HobbyFactory/PCB-GS66516B-IMS-HB/README.md

# PCB-GS66516B-IMS-HB
GaN (GS66516B) Half-Bridge designed on a metal substrate printed circuit board, including the gate drivers.

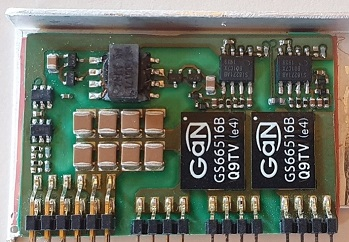
[picture p1: doc/photo.jpg]
photo_of_proto


All data included, designed in free tool KiCad. For more details check article:
Efficiency optimization of totem pole PFC with Gallium Nitride semiconductors (doi:10.15199/48.2021.06.07)
