HobbyFactory/PCB-GS66516B-IMS-HB/Board.PNG

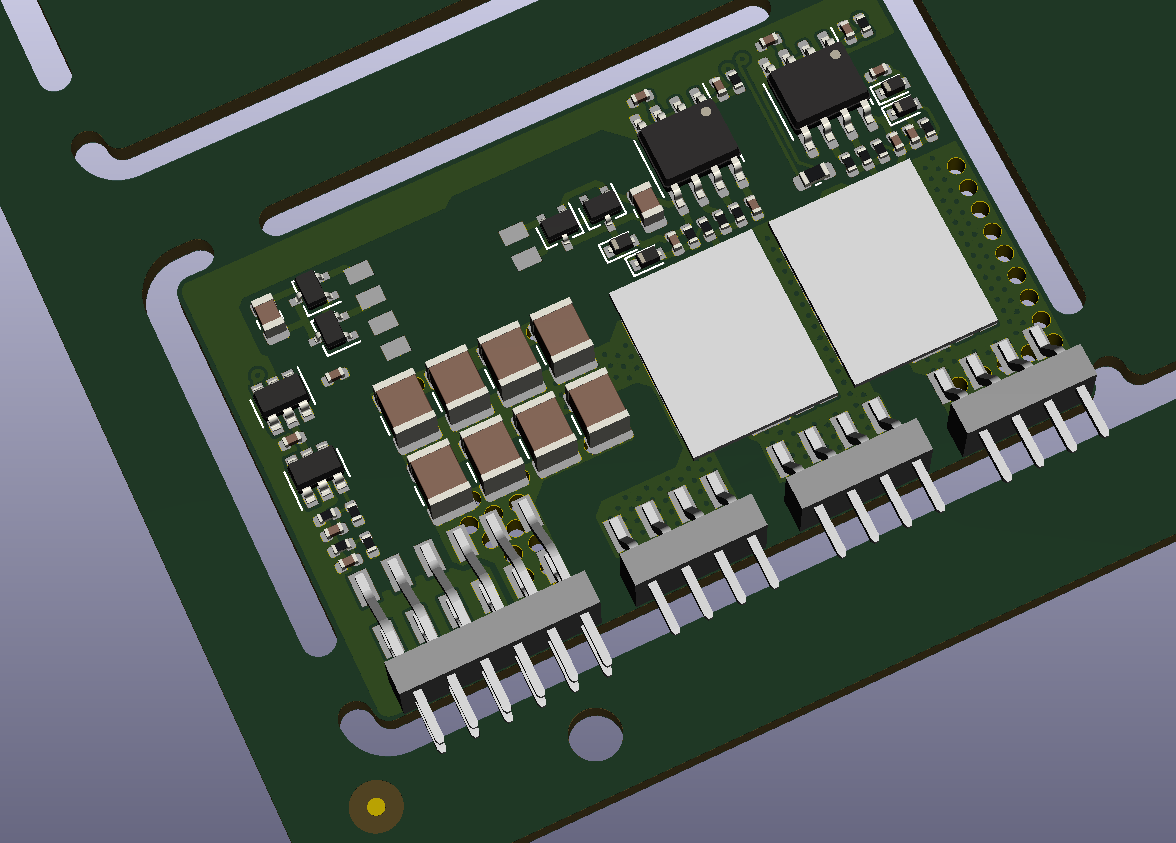
Board.PNG
