HobbyFactory/PCB-GS66516B-IMS-HB/doc/BOM.xlsx

Sheet: V2
Item | Qty | Reference(s) | Value
1 | 8 | C1, C2, C3, C4, C5, C6, C7, C8 | 150nF/630V
2 | 4 | C9, C10, C13, C17 | N/A
3 | 5 | C11, C12, C14, C16, C22 | 100nF
4 | 4 | C15, C20, C21, C23 | 1uF
5 | 2 | C18, C19 | 4.7uF
6 | 4 | D1, D2, D3, D4 | BAV99W
7 | 2 | D5, D6 | 5.6V
8 | 2 | D7, D8 | 12V
~~9~~ | ~~3~~ | ~~FID1, FID2, FID3~~ | ~~Fiducial~~
~~10~~ | ~~5~~ | ~~H1, H2, H3, H4, H5~~ | ~~Panel mounting hole~~
11 | 1 | J1 | PinHeader_SMD_2x6
12 | 3 | J2, J3, J4 | PinHeader_SMD_1x4
13 | 2 | Q1, Q2 | GS66516B-E01-MR
14 | 6 | R1, R4, R7, R8, R9, R10 | 10R
15 | 2 | R2, R5 | 2R2
16 | 4 | R3, R6, R11, R12 | 4k7
17 | 2 | R13, R14 | 1k
18 | 1 | T1 | WCT.00171
19 | 1 | TH1 | Thermistor_NTC
20 | 2 | U1, U2 | SN74LVC1G98DBVR
21 | 2 | U3, U4 | Si8271AB-IS

Sheet: V1
Item | Qty | Reference(s) | Value
1 | 8 | C1, C2, C3, C4, C5, C6, C7, C8 | 150nF
2 | 4 | C9, C10, C13, C17 | N/A
3 | 5 | C11, C12, C14, C16, C22 | 100nF
4 | 4 | C15, C20, C21, C23 | 1uF
5 | 2 | C18, C19 | 4.7uF
6 | 4 | D1, D2, D3, D4 | BAV99W
7 | 2 | D5, D6 | 5.6V
8 | 2 | D7, D8 | 12V
~~9~~ | ~~3~~ | ~~FID1, FID2, FID3~~ | ~~Fiducial~~
~~10~~ | ~~5~~ | ~~H1, H2, H3, H4, H5~~ | ~~Panel mounting hole~~
11 | 1 | J1 | PinHeader_SMD_2x6
12 | 3 | J2, J3, J4 | PinHeader_SMD_1x4
13 | 2 | Q1, Q2 | GS66516B-E01-MR
14 | 7 | R1, R4, R5, R7, R8, R9, R10 | 10R
15 | 1 | R2 | 2R
16 | 4 | R3, R6, R11, R12 | 4k7
17 | 2 | R13, R14 | 1k
18 | 1 | T1 | WCT.00171
19 | 1 | TH1 | Thermistor_NTC
20 | 2 | U1, U2 | SN74LVC1G98DBVR
21 | 2 | U3, U4 | Si8271AB-IS
