HobbyFactory/PCB-GS66516B-IMS-HB/pdf/GS66516B_IMS_AssemblyDrawing.pdf

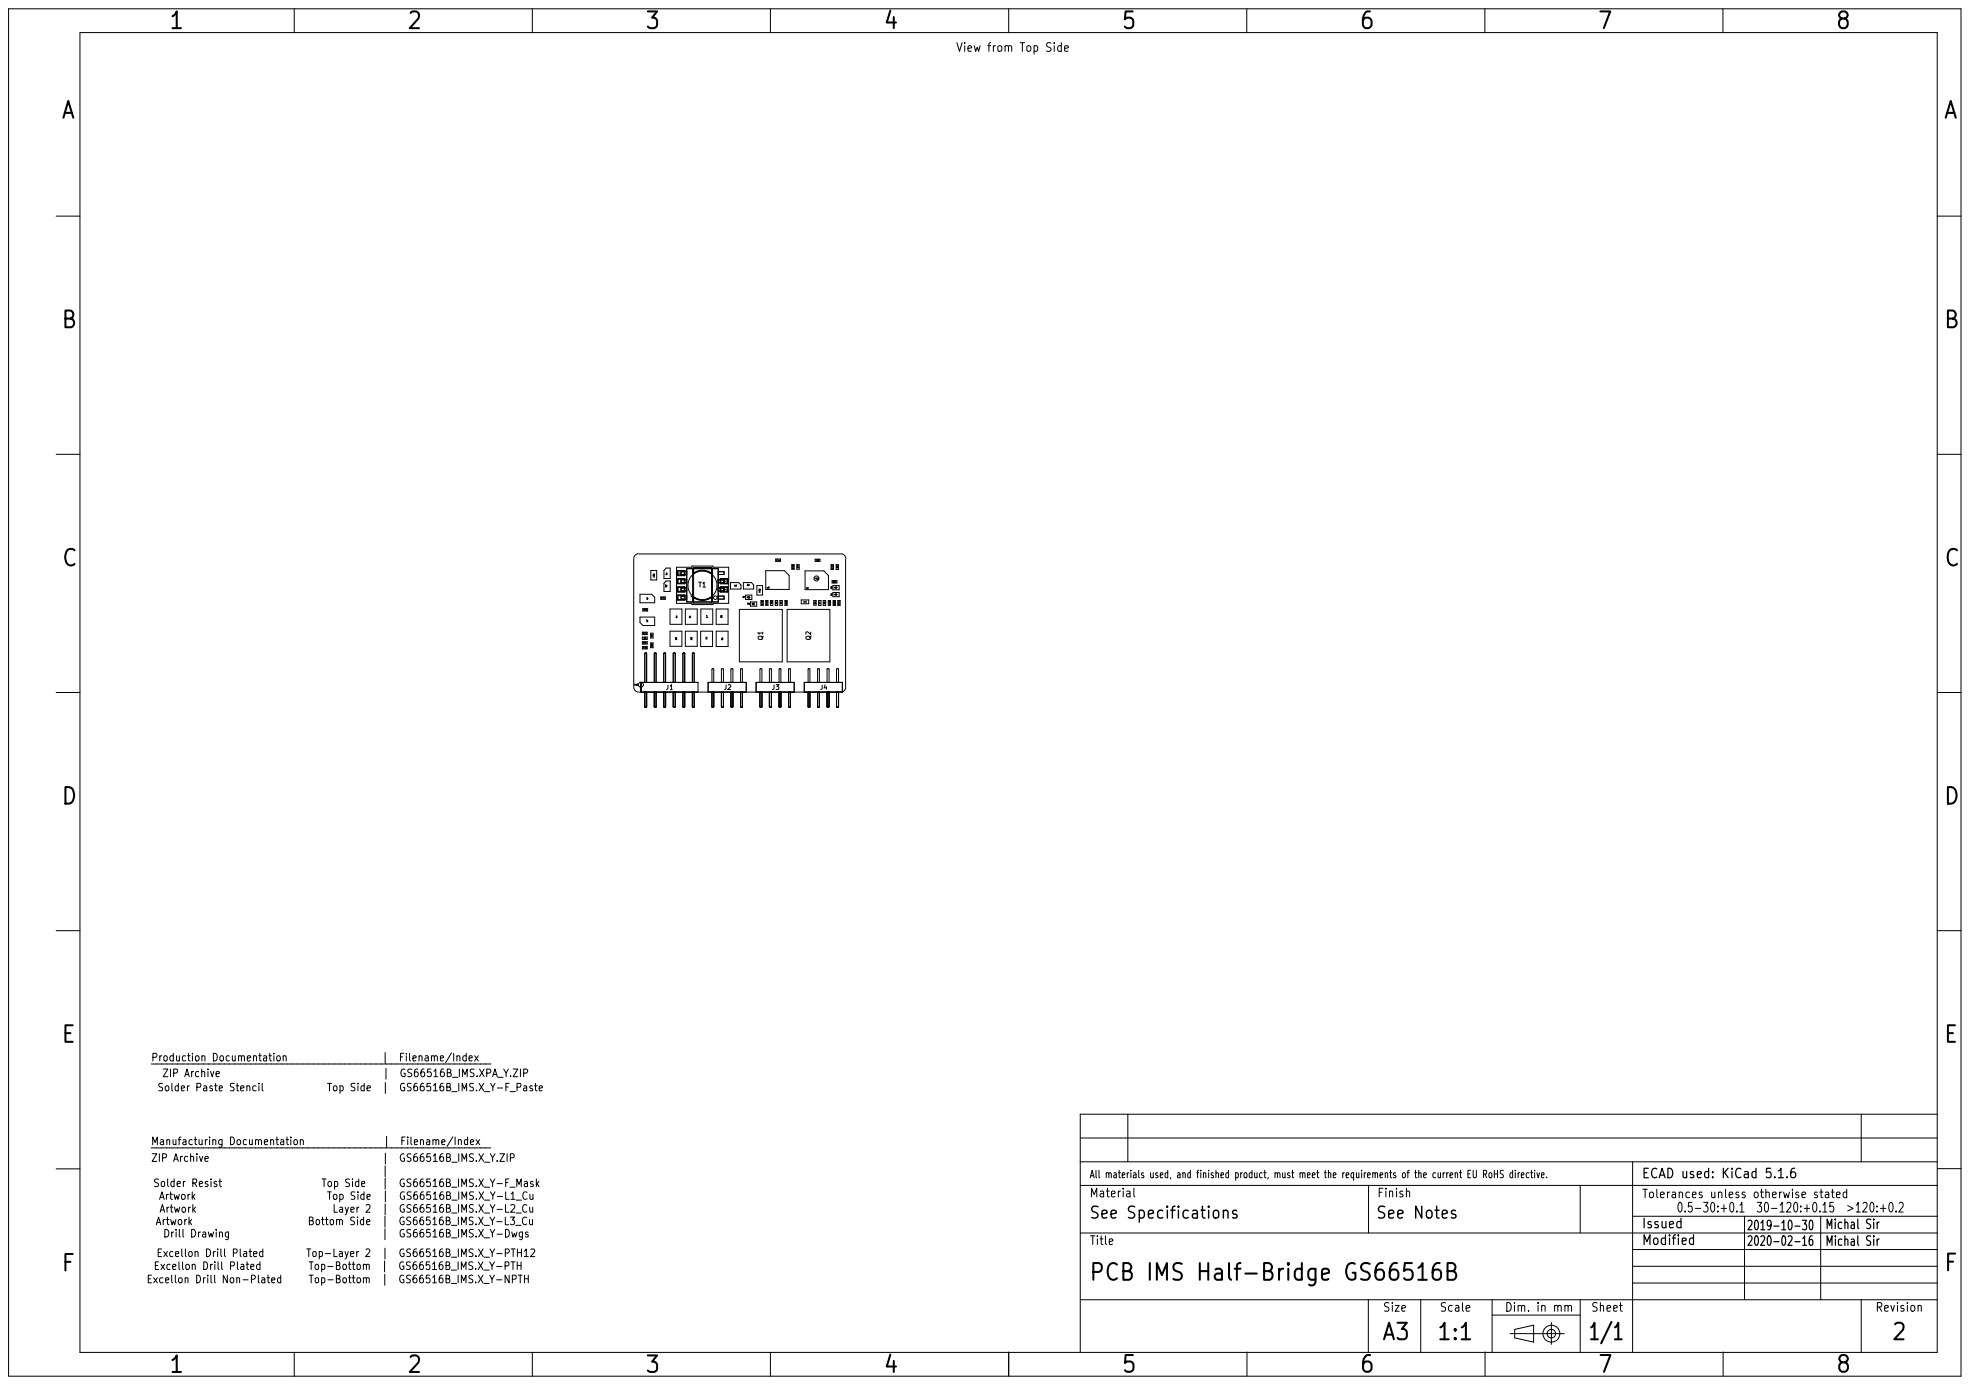
[picture p3: page 1]
