HobbyFactory/PCB-GS66516B-IMS-HB/pdf/GS66516B_IMS_Schematic.pdf

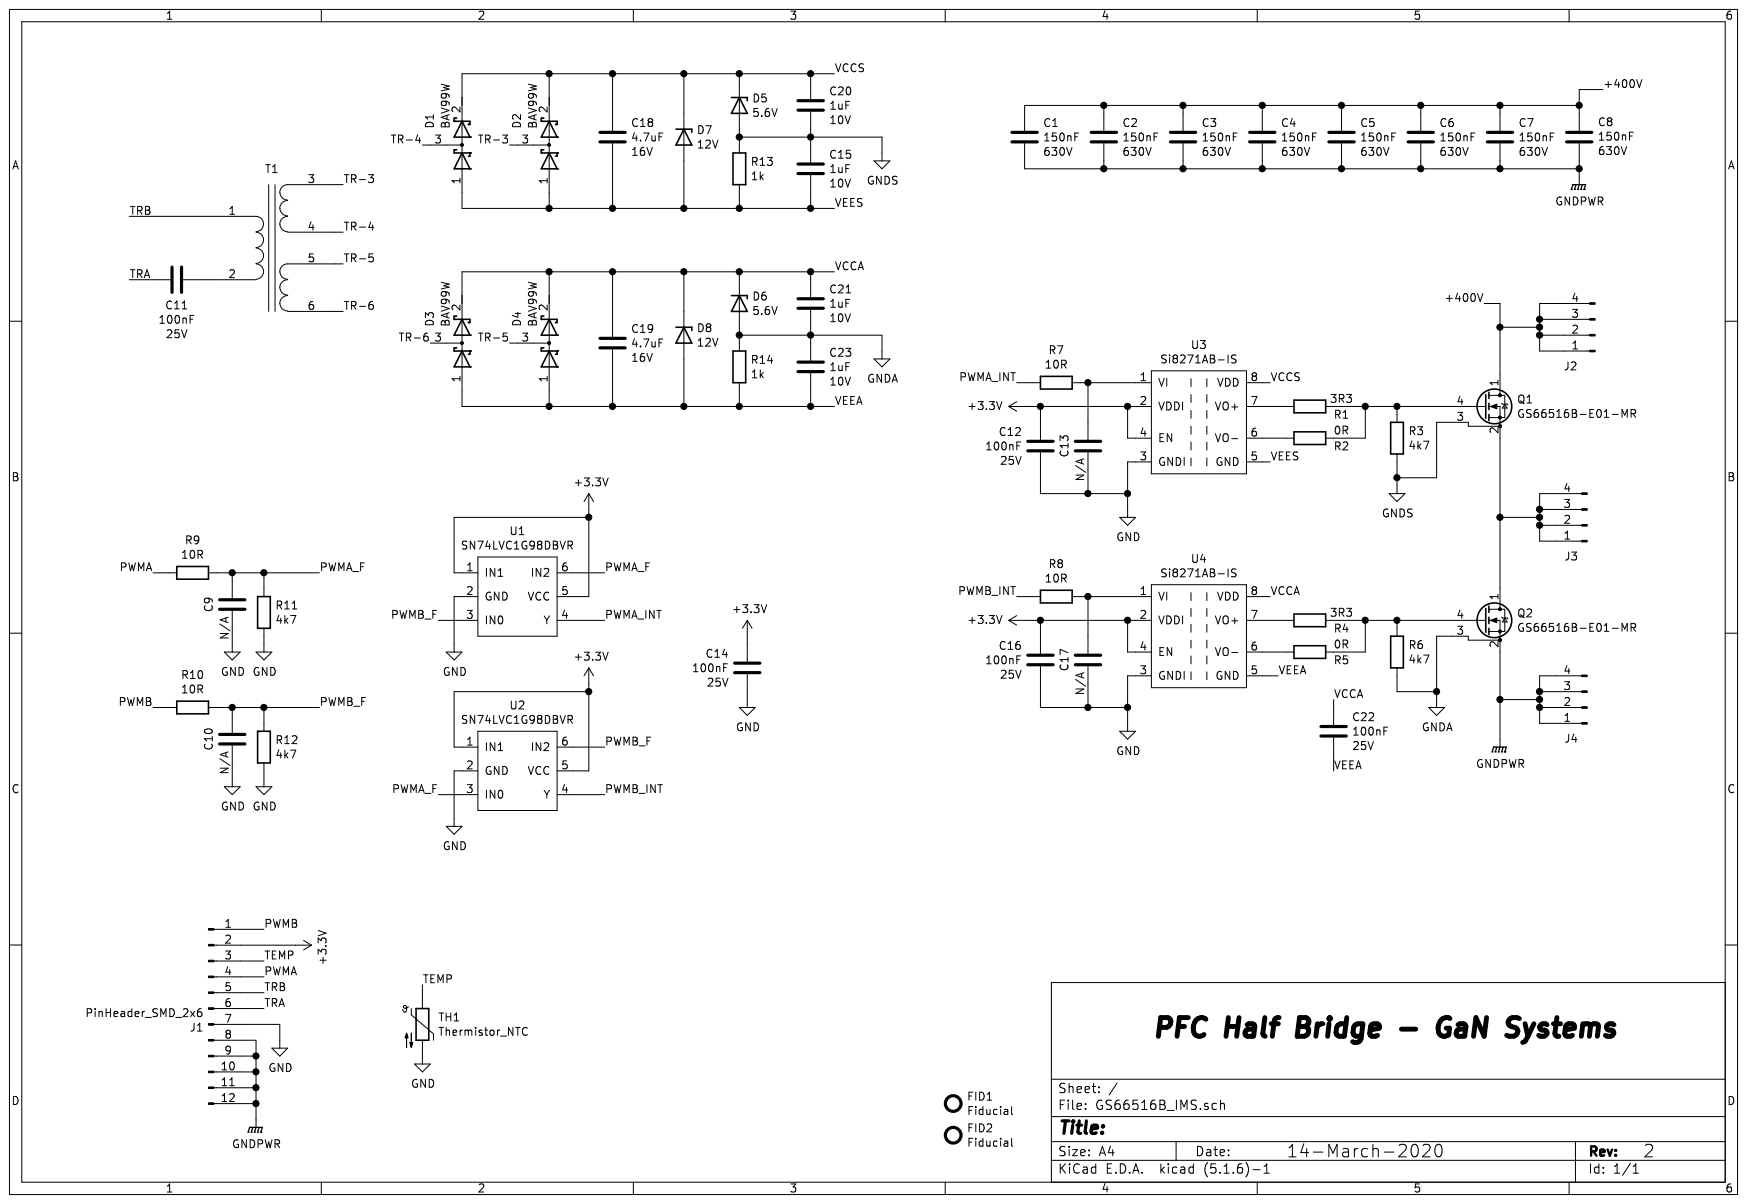
[picture p4: page 1]
