HobbyFactory/PCB-GS66516B-IMS-HB/pdf/GS66516B_IMS_PCBSpecification.pdf

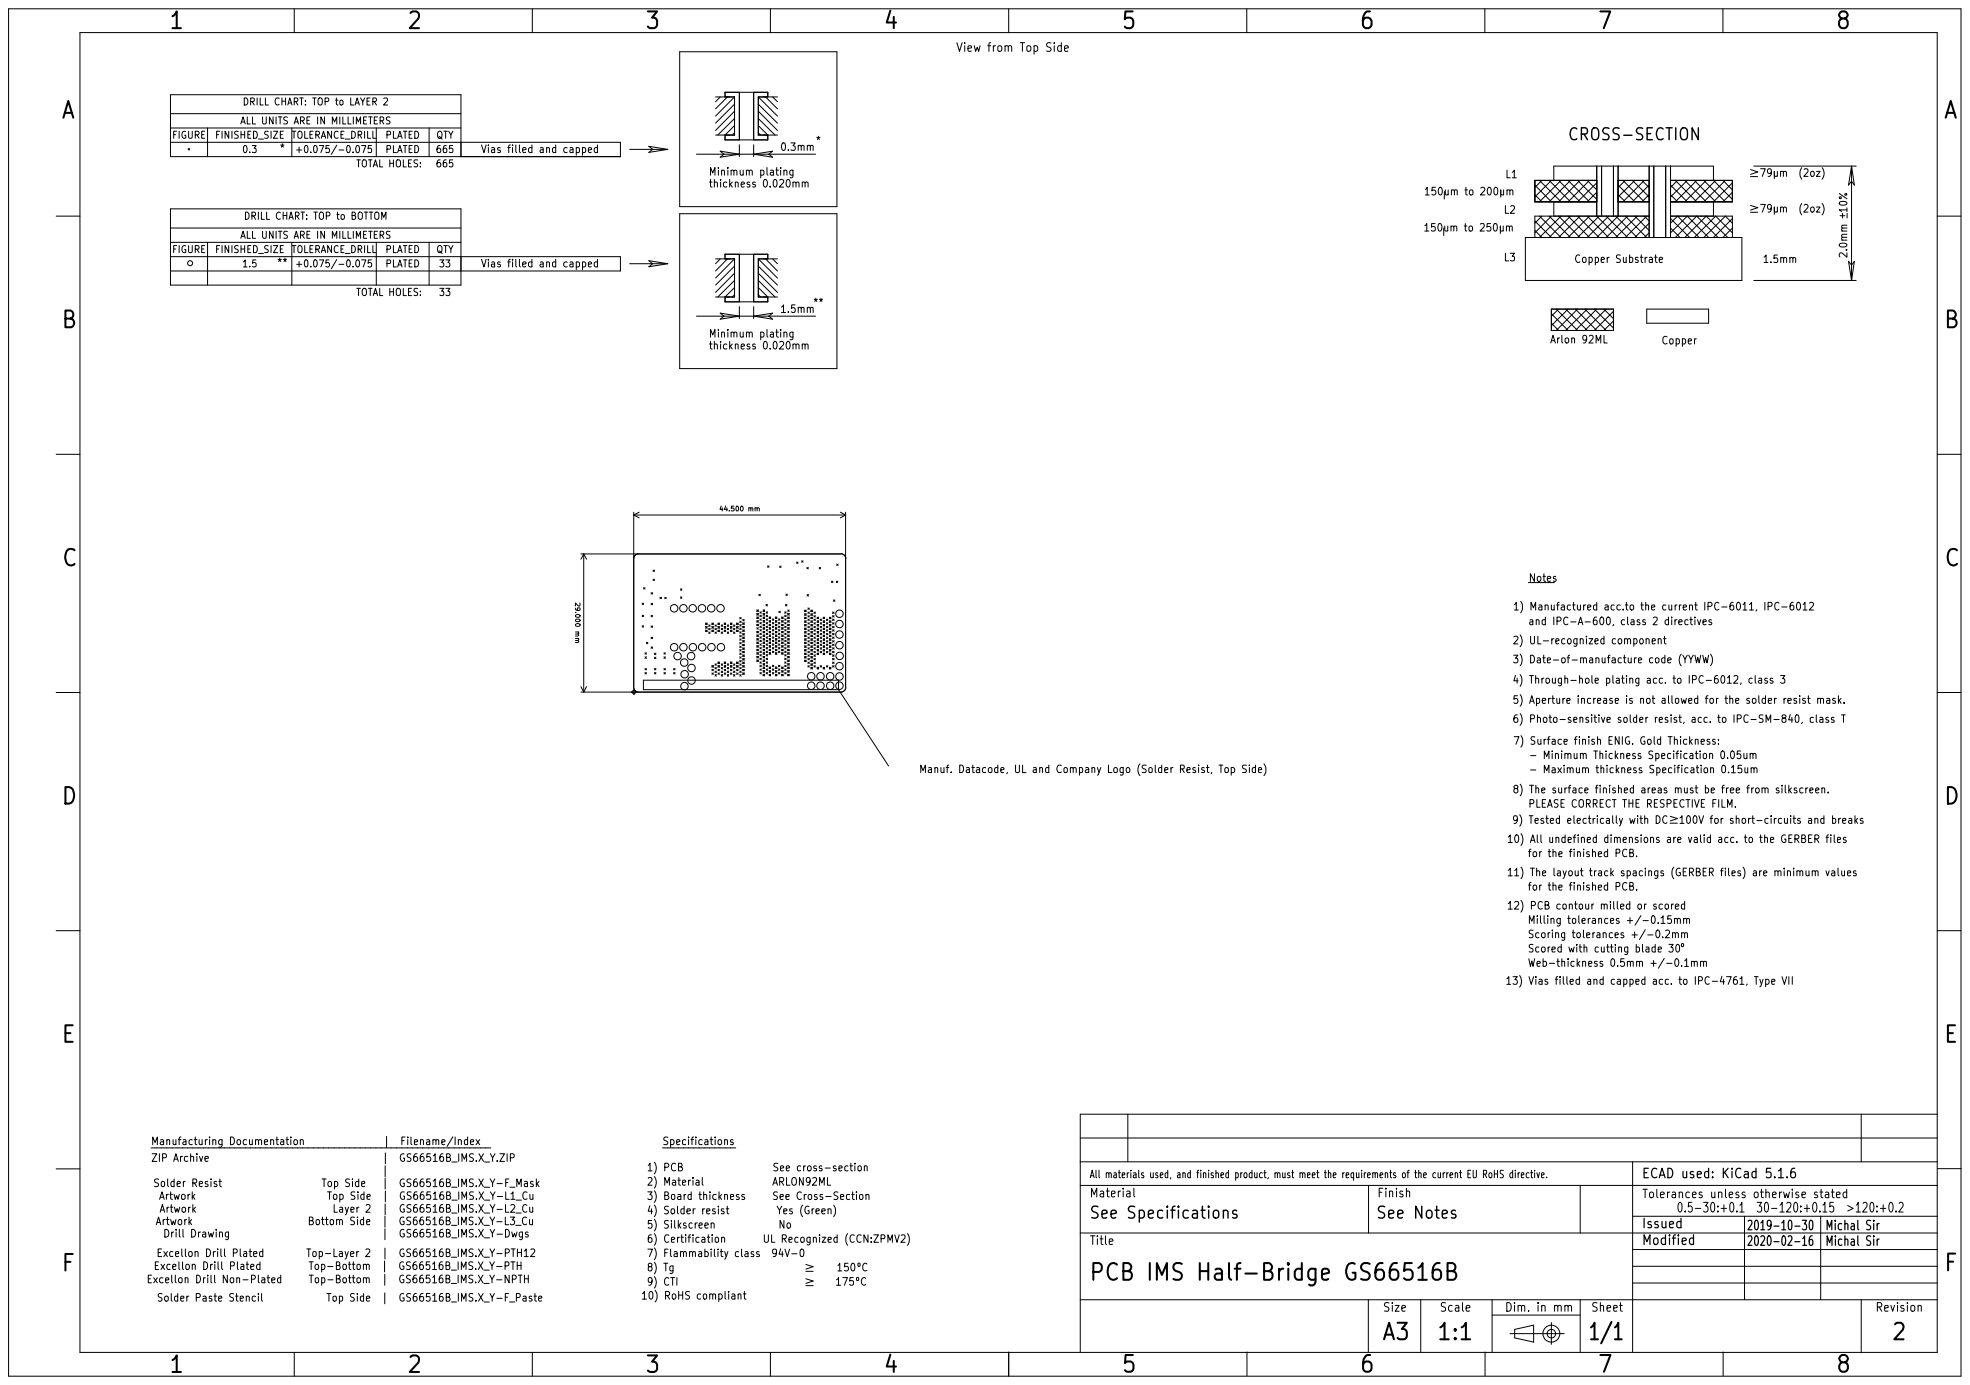
[picture p5: page 1]
