HobbyFactory/PCB-GS66516B-IMS-HB/GS66516B_IMS.kicad_pcb

## KiCad design GS66516B_IMS.kicad_pcb (2021-04-05)

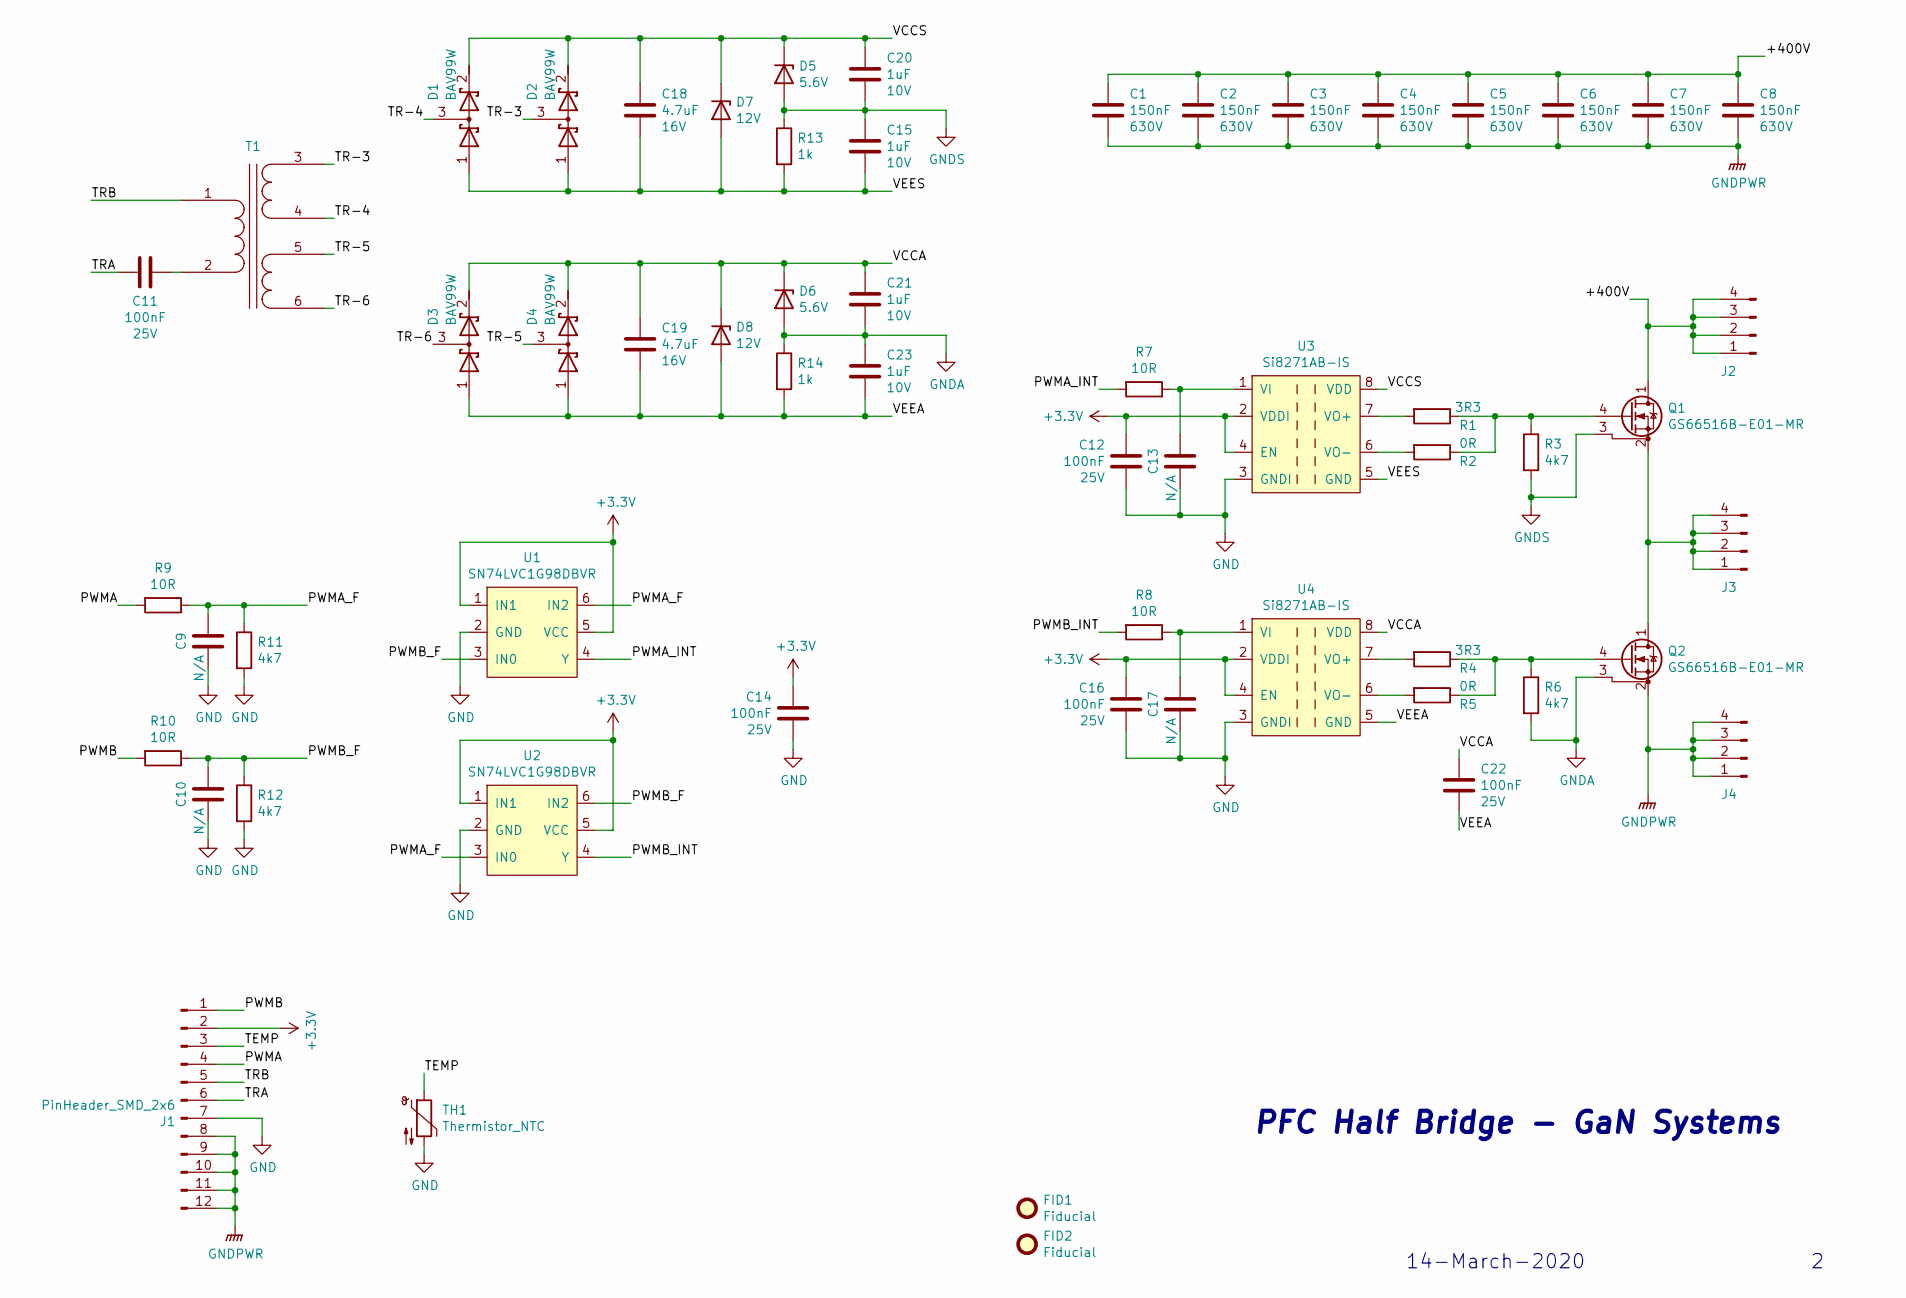
[picture p6: schematic GS66516B_IMS.sch]

Parts:
C1, C2, C3, C4, C5, C6, C7, C8: 150nF; C_1210_3225Metric; Voltage 630V
C9, C10, C13, C17: N/A; C_0402_1005Metric
C11, C12, C14, C16, C22: 100nF; C_0402_1005Metric; Voltage 25V
C15, C20, C21, C23: 1uF; C_0402_1005Metric; Voltage 10V
C18, C19: 4.7uF; C_0805_2012Metric; Voltage 16V
D1, D2, D3, D4: BAV99W; SOT-323_SC-70
D5, D6: 5.6V; D_SOD-523; Voltage 5.6V
D7: 12V; D_SOD-523; Voltage 12V
D8: 12V; D_SOD-523
FID1, FID2: Fiducial; Fiducial_0.5mm_Mask1mm
J1: PinHeader_SMD_2x6; PinHeader_SMD_Horizontal_2.00mm_2x6
J2, J3, J4: PinHeader_SMD_1x4; PinHeader_SMD_Horizontal_2.00mm_1x4_Modified
Q1, Q2: GS66516B-E01-MR; Transistor_GaN_GS66516B
R1, R4: 3R3; R_0402_1005Metric
R2, R5: 0R; R_0402_1005Metric
R3, R6, R11, R12: 4k7; R_0402_1005Metric
R7, R8, R9, R10: 10R; R_0402_1005Metric
R13, R14: 1k; R_0402_1005Metric
T1: Transformer_BPS_WCT.00171
TH1: Thermistor_NTC; R_0603_1608Metric
U1, U2: SN74LVC1G98DBVR; SOT-23-6
U3, U4: Si8271AB-IS; SOIC-8_3.9x4.9mm_P1.27mm

Connections:
+3V3: C12.1, C14.1, C16.1, J1.2, U1.1 (IN1), U1.5 (VCC), U2.1 (IN1), U2.5 (VCC), U3.2 (VDDI), U3.4 (EN), U4.2 (VDDI), U4.4 (EN)
/+400V: C1.1, C2.1, C3.1, C4.1, C5.1, C6.1, C7.1, C8.2, J2.1, J2.2, J2.3, J2.4, Q1.1 (D)
/PWMA: J1.4, R9.2
/PWMA_F: C9.1, R9.1, R11.1, U1.6 (IN2), U2.3 (IN0)
/PWMA_INT: R7.2, U1.4 (Y)
/PWMB: J1.1, R10.2
/PWMB_F: C10.1, R10.1, R12.1, U1.3 (IN0), U2.6 (IN2)
/PWMB_INT: R8.2, U2.4 (Y)
/TEMP: J1.3, TH1.1
/TR-3: D2.3 (common), T1.3 (SA)
/TR-4: D1.3 (common), T1.4 (SB)
/TR-5: D4.3 (common), T1.5 (SC)
/TR-6: D3.3 (common), T1.6 (SD)
/TRA: C11.2, J1.6
/TRB: J1.5, T1.1 (AA)
/VCCA: C19.1, C21.1, C22.1, D3.2 (K), D4.2 (K), D6.1 (K), D8.1 (K), U4.8 (VDD)
/VCCS: C18.1, C20.1, D1.2 (K), D2.2 (K), D5.1 (K), D7.1 (K), U3.8 (VDD)
/VEEA: C19.2, C22.2, C23.2, D3.1 (A), D4.1 (A), D8.2 (A), R14.2, U4.5 (GND)
/VEES: C15.2, C18.2, D1.1 (A), D2.1 (A), D7.2 (A), R13.2, U3.5 (GND)
GND: C9.2, C10.2, C12.2, C13.2, C14.2, C16.2, C17.2, J1.7, R11.2, R12.2, TH1.2, U1.2 (GND), U2.2 (GND), U3.3 (GNDI), U4.3 (GNDI)
GNDA: C21.2, C23.1, D6.2 (A), Q2.3 (DS), R6.2, R14.1
GNDPWR: C1.2, C2.2, C3.2, C4.2, C5.2, C6.2, C7.2, C8.1, J1.8, J1.9, J1.10, J1.11, J1.12, J4.1, J4.2, J4.3, J4.4, Q2.2 (S)
GNDS: C15.1, C20.2, D5.2 (A), Q1.3 (DS), R3.2, R13.1
unnamed: C11.1, T1.2 (AB)
unnamed: C13.1, R7.1, U3.1 (VI)
unnamed: C17.1, R8.1, U4.1 (VI)
unnamed: J3.1, J3.2, J3.3, J3.4, Q1.2 (S), Q2.1 (D)
unnamed: Q1.4 (G), R1.1, R2.1, R3.1
unnamed: Q2.4 (G), R4.1, R5.1, R6.1
unnamed: R1.2, U3.7 (VO+)
unnamed: R2.2, U3.6 (VO-)
unnamed: R4.2, U4.7 (VO+)
unnamed: R5.2, U4.6 (VO-)

Notes on the sheet:
PFC Half Bridge - GaN Systems
14-March-2020

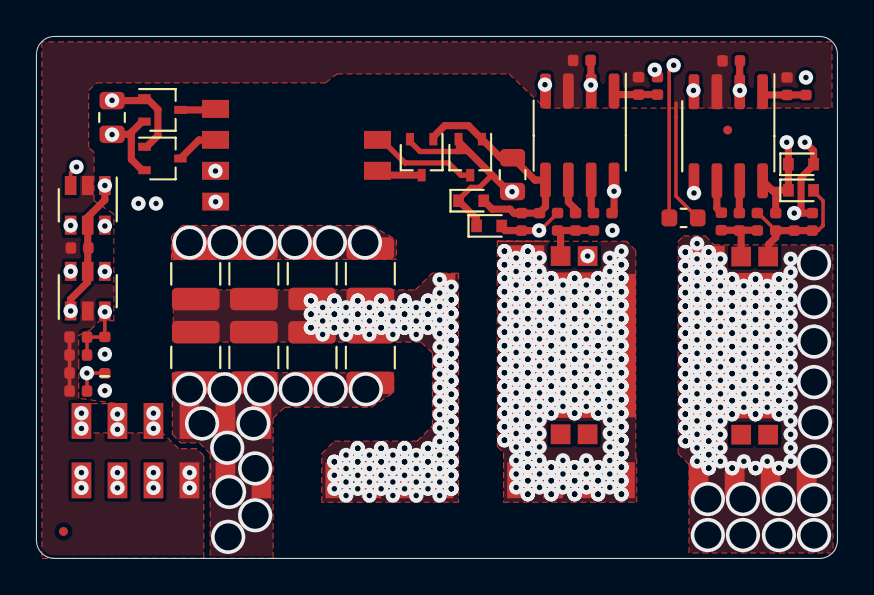
[picture p7: board GS66516B_IMS.kicad_pcb from above]

Board: 4 copper layers, 44.5 x 29.0 mm, 59 parts (0 on the bottom side), 33 nets.
